stothe2/gmox-kintex-7/cryotest-kintex7.sch

## EAGLE design cryotest-kintex7.sch (2016-02-13)

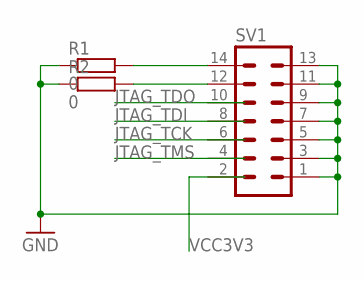
[picture p3: schematic cryotest-kintex7.sch, sheet 1]

Parts:
R1, R2: 0; R0805
SV1: MA07-2

Connections:
12_SV1: R2.2, SV1.12
14_SV1: R1.2, SV1.14
GND: R1.1, R2.1, SV1.1, SV1.3, SV1.5, SV1.7, SV1.9, SV1.11, SV1.13

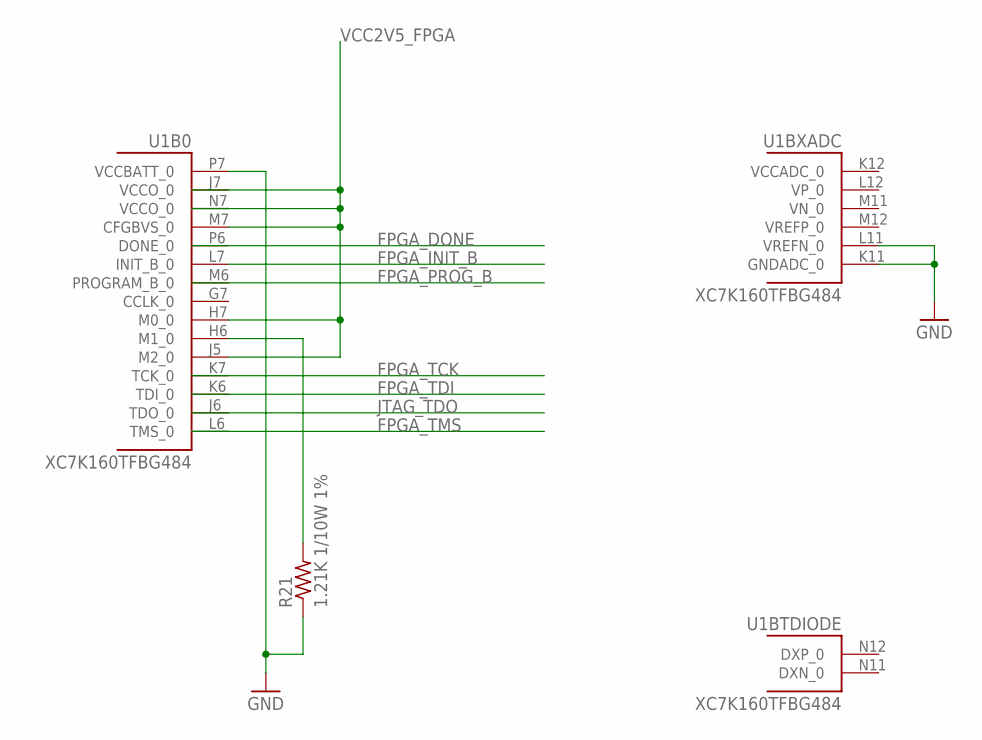
[picture p4: schematic cryotest-kintex7.sch, sheet 2]

Parts:
R21: 1.21K 1/10W 1%; R0402
U1: XC7K160TFBG484; FF484

Connections:
FPGA_INIT_B: U1.L7 (INIT_B_0)
FPGA_M1: R21.2, U1.H6 (M1_0)
GND: R21.1, U1.K11 (GNDADC_0), U1.L11 (VREFN_0), U1.P7 (VCCBATT_0)
VCC2V5_FPGA: U1.H7 (M0_0), U1.J5 (M2_0), U1.M7 (CFGBVS_0)

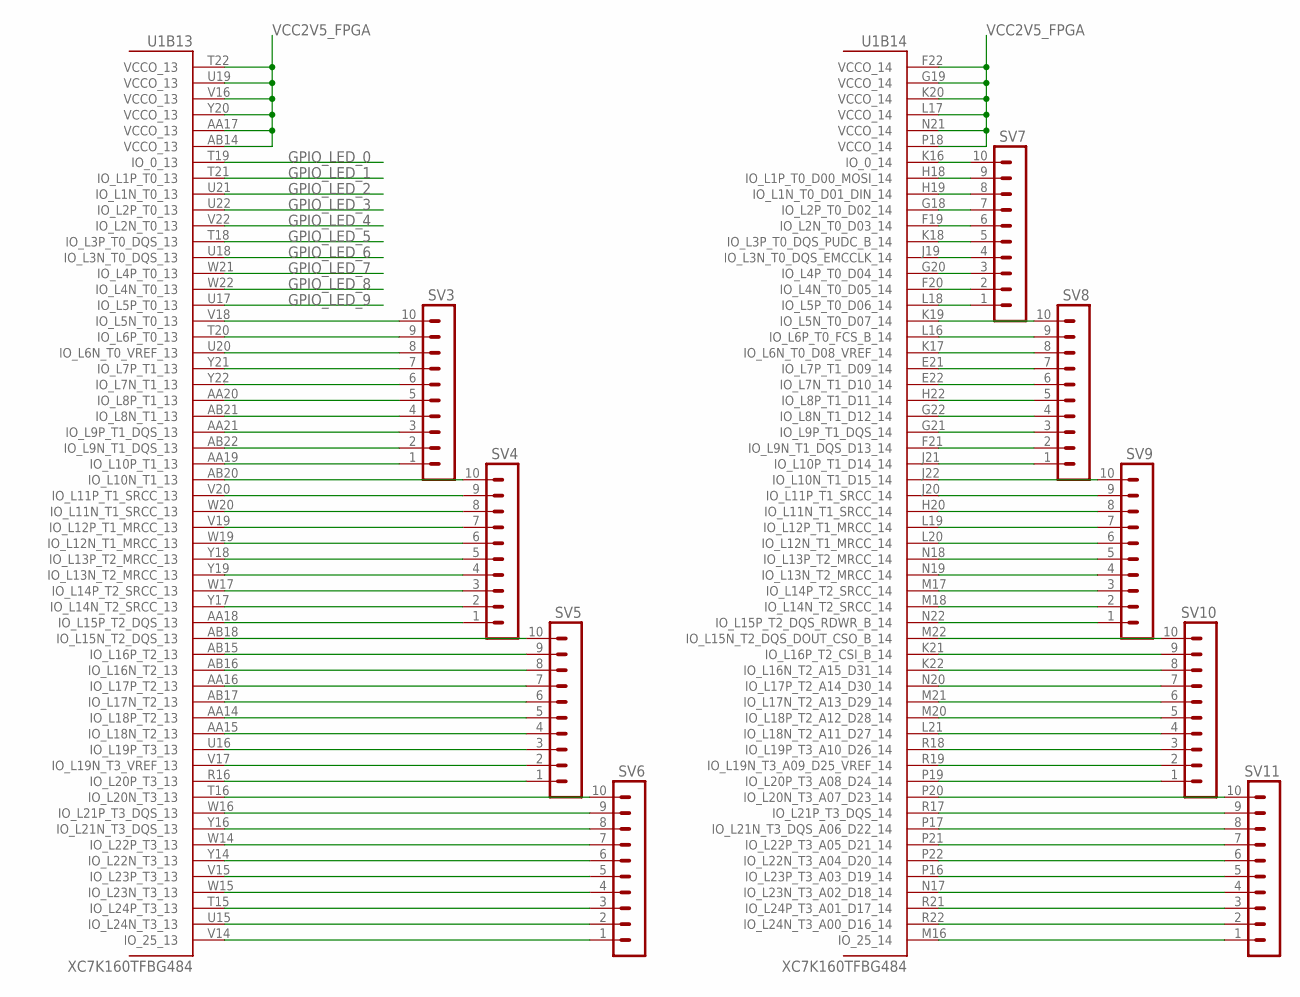
[picture p5: schematic cryotest-kintex7.sch, sheet 3]

Parts:
SV3, SV4, SV5, SV6, SV7, SV8, SV9, SV10, SV11: MA10-1
U1: XC7K160TFBG484; FF484

Connections:
GPIO_LED_0: U1.T19 (IO_0_13)
GPIO_LED_1: U1.T21 (IO_L1P_T0_13)
GPIO_LED_2: U1.U21 (IO_L1N_T0_13)
GPIO_LED_3: U1.U22 (IO_L2P_T0_13)
GPIO_LED_4: U1.V22 (IO_L2N_T0_13)
GPIO_LED_5: U1.T18 (IO_L3P_T0_DQS_13)
GPIO_LED_6: U1.U18 (IO_L3N_T0_DQS_13)
GPIO_LED_7: U1.W21 (IO_L4P_T0_13)
GPIO_LED_8: U1.W22 (IO_L4N_T0_13)
GPIO_LED_9: U1.U17 (IO_L5P_T0_13)
unnamed: SV3.10, U1.V18 (IO_L5N_T0_13)
unnamed: SV3.9, U1.T20 (IO_L6P_T0_13)
unnamed: SV3.8, U1.U20 (IO_L6N_T0_VREF_13)
unnamed: SV3.7, U1.Y21 (IO_L7P_T1_13)
unnamed: SV3.6, U1.Y22 (IO_L7N_T1_13)
unnamed: SV3.5, U1.AA20 (IO_L8P_T1_13)
unnamed: SV3.4, U1.AB21 (IO_L8N_T1_13)
unnamed: SV3.3, U1.AA21 (IO_L9P_T1_DQS_13)
unnamed: SV3.2, U1.AB22 (IO_L9N_T1_DQS_13)
unnamed: SV3.1, U1.AA19 (IO_L10P_T1_13)
unnamed: SV4.10, U1.AB20 (IO_L10N_T1_13)
unnamed: SV4.9, U1.V20 (IO_L11P_T1_SRCC_13)
unnamed: SV4.8, U1.W20 (IO_L11N_T1_SRCC_13)
unnamed: SV4.7, U1.V19 (IO_L12P_T1_MRCC_13)
unnamed: SV4.6, U1.W19 (IO_L12N_T1_MRCC_13)
unnamed: SV4.5, U1.Y18 (IO_L13P_T2_MRCC_13)
unnamed: SV4.4, U1.Y19 (IO_L13N_T2_MRCC_13)
unnamed: SV4.3, U1.W17 (IO_L14P_T2_SRCC_13)
unnamed: SV4.2, U1.Y17 (IO_L14N_T2_SRCC_13)
unnamed: SV4.1, U1.AA18 (IO_L15P_T2_DQS_13)
unnamed: SV5.10, U1.AB18 (IO_L15N_T2_DQS_13)
unnamed: SV5.9, U1.AB15 (IO_L16P_T2_13)
unnamed: SV5.8, U1.AB16 (IO_L16N_T2_13)
unnamed: SV5.7, U1.AA16 (IO_L17P_T2_13)
unnamed: SV5.6, U1.AB17 (IO_L17N_T2_13)
unnamed: SV5.5, U1.AA14 (IO_L18P_T2_13)
unnamed: SV5.4, U1.AA15 (IO_L18N_T2_13)
unnamed: SV5.3, U1.U16 (IO_L19P_T3_13)
unnamed: SV5.2, U1.V17 (IO_L19N_T3_VREF_13)
unnamed: SV5.1, U1.R16 (IO_L20P_T3_13)
unnamed: SV6.10, U1.T16 (IO_L20N_T3_13)
unnamed: SV6.9, U1.W16 (IO_L21P_T3_DQS_13)
unnamed: SV6.8, U1.Y16 (IO_L21N_T3_DQS_13)
unnamed: SV6.7, U1.W14 (IO_L22P_T3_13)
unnamed: SV6.6, U1.Y14 (IO_L22N_T3_13)
unnamed: SV6.5, U1.V15 (IO_L23P_T3_13)
unnamed: SV6.4, U1.W15 (IO_L23N_T3_13)
unnamed: SV6.3, U1.T15 (IO_L24P_T3_13)
unnamed: SV6.2, U1.U15 (IO_L24N_T3_13)
unnamed: SV6.1, U1.V14 (IO_25_13)
unnamed: SV7.10, U1.K16 (IO_0_14)
unnamed: SV7.9, U1.H18 (IO_L1P_T0_D00_MOSI_14)
unnamed: SV7.8, U1.H19 (IO_L1N_T0_D01_DIN_14)
unnamed: SV7.7, U1.G18 (IO_L2P_T0_D02_14)
unnamed: SV7.6, U1.F19 (IO_L2N_T0_D03_14)
unnamed: SV7.5, U1.K18 (IO_L3P_T0_DQS_PUDC_B_14)
unnamed: SV7.4, U1.J19 (IO_L3N_T0_DQS_EMCCLK_14)
unnamed: SV7.3, U1.G20 (IO_L4P_T0_D04_14)
unnamed: SV7.2, U1.F20 (IO_L4N_T0_D05_14)
unnamed: SV7.1, U1.L18 (IO_L5P_T0_D06_14)
unnamed: SV8.10, U1.K19 (IO_L5N_T0_D07_14)
unnamed: SV8.9, U1.L16 (IO_L6P_T0_FCS_B_14)
unnamed: SV8.8, U1.K17 (IO_L6N_T0_D08_VREF_14)
unnamed: SV8.7, U1.E21 (IO_L7P_T1_D09_14)
unnamed: SV8.6, U1.E22 (IO_L7N_T1_D10_14)
unnamed: SV8.5, U1.H22 (IO_L8P_T1_D11_14)
unnamed: SV8.4, U1.G22 (IO_L8N_T1_D12_14)
unnamed: SV8.3, U1.G21 (IO_L9P_T1_DQS_14)
unnamed: SV8.2, U1.F21 (IO_L9N_T1_DQS_D13_14)
unnamed: SV8.1, U1.J21 (IO_L10P_T1_D14_14)
unnamed: SV9.10, U1.J22 (IO_L10N_T1_D15_14)
unnamed: SV9.9, U1.J20 (IO_L11P_T1_SRCC_14)
unnamed: SV9.8, U1.H20 (IO_L11N_T1_SRCC_14)
unnamed: SV9.7, U1.L19 (IO_L12P_T1_MRCC_14)
unnamed: SV9.6, U1.L20 (IO_L12N_T1_MRCC_14)
unnamed: SV9.5, U1.N18 (IO_L13P_T2_MRCC_14)
unnamed: SV9.4, U1.N19 (IO_L13N_T2_MRCC_14)
unnamed: SV9.3, U1.M17 (IO_L14P_T2_SRCC_14)
unnamed: SV9.2, U1.M18 (IO_L14N_T2_SRCC_14)
unnamed: SV9.1, U1.N22 (IO_L15P_T2_DQS_RDWR_B_14)
unnamed: SV10.10, U1.M22 (IO_L15N_T2_DQS_DOUT_CSO_B_14)
unnamed: SV10.9, U1.K21 (IO_L16P_T2_CSI_B_14)
unnamed: SV10.8, U1.K22 (IO_L16N_T2_A15_D31_14)
unnamed: SV10.7, U1.N20 (IO_L17P_T2_A14_D30_14)
unnamed: SV10.6, U1.M21 (IO_L17N_T2_A13_D29_14)
unnamed: SV10.5, U1.M20 (IO_L18P_T2_A12_D28_14)
unnamed: SV10.4, U1.L21 (IO_L18N_T2_A11_D27_14)
unnamed: SV10.3, U1.R18 (IO_L19P_T3_A10_D26_14)
unnamed: SV10.2, U1.R19 (IO_L19N_T3_A09_D25_VREF_14)
unnamed: SV10.1, U1.P19 (IO_L20P_T3_A08_D24_14)
unnamed: SV11.10, U1.P20 (IO_L20N_T3_A07_D23_14)
unnamed: SV11.9, U1.R17 (IO_L21P_T3_DQS_14)
unnamed: SV11.8, U1.P17 (IO_L21N_T3_DQS_A06_D22_14)
unnamed: SV11.7, U1.P21 (IO_L22P_T3_A05_D21_14)
unnamed: SV11.6, U1.P22 (IO_L22N_T3_A04_D20_14)
unnamed: SV11.5, U1.P16 (IO_L23P_T3_A03_D19_14)
unnamed: SV11.4, U1.N17 (IO_L23N_T3_A02_D18_14)
unnamed: SV11.3, U1.R21 (IO_L24P_T3_A01_D17_14)
unnamed: SV11.2, U1.R22 (IO_L24N_T3_A00_D16_14)
unnamed: SV11.1, U1.M16 (IO_25_14)
VCC2V5_FPGA: U1.AA17 (VCCO_13), U1.AB14 (VCCO_13), U1.F22 (VCCO_14), U1.G19 (VCCO_14), U1.K20 (VCCO_14), U1.L17 (VCCO_14), U1.N21 (VCCO_14), U1.P18 (VCCO_14), U1.T22 (VCCO_13), U1.U19 (VCCO_13), U1.V16 (VCCO_13), U1.Y20 (VCCO_13)

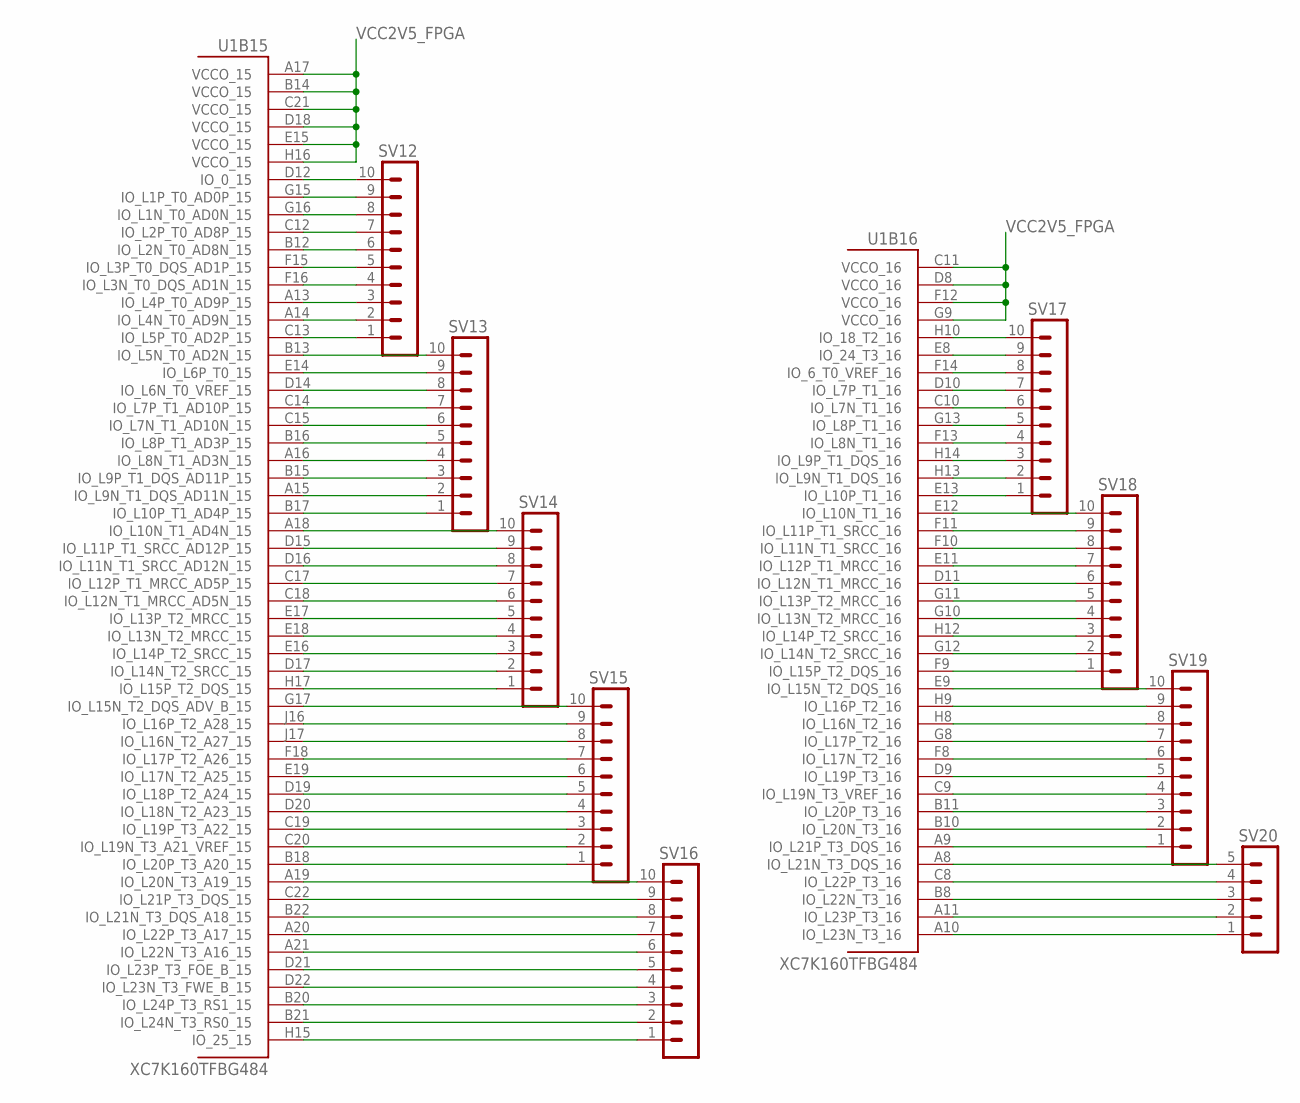
[picture p6: schematic cryotest-kintex7.sch, sheet 4]

Parts:
SV12, SV13, SV14, SV15, SV16, SV17, SV18, SV19: MA10-1
SV20: MA05-1
U1: XC7K160TFBG484; FF484

Connections:
unnamed: SV12.1, U1.C13 (IO_L5P_T0_AD2P_15)
unnamed: SV12.2, U1.A14 (IO_L4N_T0_AD9N_15)
unnamed: SV12.3, U1.A13 (IO_L4P_T0_AD9P_15)
unnamed: SV12.4, U1.F16 (IO_L3N_T0_DQS_AD1N_15)
unnamed: SV12.5, U1.F15 (IO_L3P_T0_DQS_AD1P_15)
unnamed: SV12.6, U1.B12 (IO_L2N_T0_AD8N_15)
unnamed: SV12.7, U1.C12 (IO_L2P_T0_AD8P_15)
unnamed: SV12.8, U1.G16 (IO_L1N_T0_AD0N_15)
unnamed: SV12.9, U1.G15 (IO_L1P_T0_AD0P_15)
unnamed: SV12.10, U1.D12 (IO_0_15)
unnamed: SV13.1, U1.B17 (IO_L10P_T1_AD4P_15)
unnamed: SV13.2, U1.A15 (IO_L9N_T1_DQS_AD11N_15)
unnamed: SV13.3, U1.B15 (IO_L9P_T1_DQS_AD11P_15)
unnamed: SV13.4, U1.A16 (IO_L8N_T1_AD3N_15)
unnamed: SV13.5, U1.B16 (IO_L8P_T1_AD3P_15)
unnamed: SV13.6, U1.C15 (IO_L7N_T1_AD10N_15)
unnamed: SV13.7, U1.C14 (IO_L7P_T1_AD10P_15)
unnamed: SV13.8, U1.D14 (IO_L6N_T0_VREF_15)
unnamed: SV13.9, U1.E14 (IO_L6P_T0_15)
unnamed: SV13.10, U1.B13 (IO_L5N_T0_AD2N_15)
unnamed: SV14.1, U1.H17 (IO_L15P_T2_DQS_15)
unnamed: SV14.2, U1.D17 (IO_L14N_T2_SRCC_15)
unnamed: SV14.3, U1.E16 (IO_L14P_T2_SRCC_15)
unnamed: SV14.4, U1.E18 (IO_L13N_T2_MRCC_15)
unnamed: SV14.5, U1.E17 (IO_L13P_T2_MRCC_15)
unnamed: SV14.6, U1.C18 (IO_L12N_T1_MRCC_AD5N_15)
unnamed: SV14.7, U1.C17 (IO_L12P_T1_MRCC_AD5P_15)
unnamed: SV14.8, U1.D16 (IO_L11N_T1_SRCC_AD12N_15)
unnamed: SV14.9, U1.D15 (IO_L11P_T1_SRCC_AD12P_15)
unnamed: SV14.10, U1.A18 (IO_L10N_T1_AD4N_15)
unnamed: SV15.1, U1.B18 (IO_L20P_T3_A20_15)
unnamed: SV15.2, U1.C20 (IO_L19N_T3_A21_VREF_15)
unnamed: SV15.3, U1.C19 (IO_L19P_T3_A22_15)
unnamed: SV15.4, U1.D20 (IO_L18N_T2_A23_15)
unnamed: SV15.5, U1.D19 (IO_L18P_T2_A24_15)
unnamed: SV15.6, U1.E19 (IO_L17N_T2_A25_15)
unnamed: SV15.7, U1.F18 (IO_L17P_T2_A26_15)
unnamed: SV15.8, U1.J17 (IO_L16N_T2_A27_15)
unnamed: SV15.9, U1.J16 (IO_L16P_T2_A28_15)
unnamed: SV15.10, U1.G17 (IO_L15N_T2_DQS_ADV_B_15)
unnamed: SV16.1, U1.H15 (IO_25_15)
unnamed: SV16.2, U1.B21 (IO_L24N_T3_RS0_15)
unnamed: SV16.3, U1.B20 (IO_L24P_T3_RS1_15)
unnamed: SV16.4, U1.D22 (IO_L23N_T3_FWE_B_15)
unnamed: SV16.5, U1.D21 (IO_L23P_T3_FOE_B_15)
unnamed: SV16.6, U1.A21 (IO_L22N_T3_A16_15)
unnamed: SV16.7, U1.A20 (IO_L22P_T3_A17_15)
unnamed: SV16.8, U1.B22 (IO_L21N_T3_DQS_A18_15)
unnamed: SV16.9, U1.C22 (IO_L21P_T3_DQS_15)
unnamed: SV16.10, U1.A19 (IO_L20N_T3_A19_15)
unnamed: SV17.1, U1.E13 (IO_L10P_T1_16)
unnamed: SV17.2, U1.H13 (IO_L9N_T1_DQS_16)
unnamed: SV17.3, U1.H14 (IO_L9P_T1_DQS_16)
unnamed: SV17.4, U1.F13 (IO_L8N_T1_16)
unnamed: SV17.5, U1.G13 (IO_L8P_T1_16)
unnamed: SV17.6, U1.C10 (IO_L7N_T1_16)
unnamed: SV17.7, U1.D10 (IO_L7P_T1_16)
unnamed: SV17.8, U1.F14 (IO_6_T0_VREF_16)
unnamed: SV17.9, U1.E8 (IO_24_T3_16)
unnamed: SV17.10, U1.H10 (IO_18_T2_16)
unnamed: SV18.1, U1.F9 (IO_L15P_T2_DQS_16)
unnamed: SV18.2, U1.G12 (IO_L14N_T2_SRCC_16)
unnamed: SV18.3, U1.H12 (IO_L14P_T2_SRCC_16)
unnamed: SV18.4, U1.G10 (IO_L13N_T2_MRCC_16)
unnamed: SV18.5, U1.G11 (IO_L13P_T2_MRCC_16)
unnamed: SV18.6, U1.D11 (IO_L12N_T1_MRCC_16)
unnamed: SV18.7, U1.E11 (IO_L12P_T1_MRCC_16)
unnamed: SV18.8, U1.F10 (IO_L11N_T1_SRCC_16)
unnamed: SV18.9, U1.F11 (IO_L11P_T1_SRCC_16)
unnamed: SV18.10, U1.E12 (IO_L10N_T1_16)
unnamed: SV19.1, U1.A9 (IO_L21P_T3_DQS_16)
unnamed: SV19.2, U1.B10 (IO_L20N_T3_16)
unnamed: SV19.3, U1.B11 (IO_L20P_T3_16)
unnamed: SV19.4, U1.C9 (IO_L19N_T3_VREF_16)
unnamed: SV19.5, U1.D9 (IO_L19P_T3_16)
unnamed: SV19.6, U1.F8 (IO_L17N_T2_16)
unnamed: SV19.7, U1.G8 (IO_L17P_T2_16)
unnamed: SV19.8, U1.H8 (IO_L16N_T2_16)
unnamed: SV19.9, U1.H9 (IO_L16P_T2_16)
unnamed: SV19.10, U1.E9 (IO_L15N_T2_DQS_16)
unnamed: SV20.1, U1.A10 (IO_L23N_T3_16)
unnamed: SV20.2, U1.A11 (IO_L23P_T3_16)
unnamed: SV20.3, U1.B8 (IO_L22N_T3_16)
unnamed: SV20.4, U1.C8 (IO_L22P_T3_16)
unnamed: SV20.5, U1.A8 (IO_L21N_T3_DQS_16)
VCC2V5_FPGA: U1.A17 (VCCO_15), U1.B14 (VCCO_15), U1.C11 (VCCO_16), U1.C21 (VCCO_15), U1.D8 (VCCO_16), U1.D18 (VCCO_15), U1.E15 (VCCO_15), U1.F12 (VCCO_16), U1.G9 (VCCO_16), U1.H16 (VCCO_15)

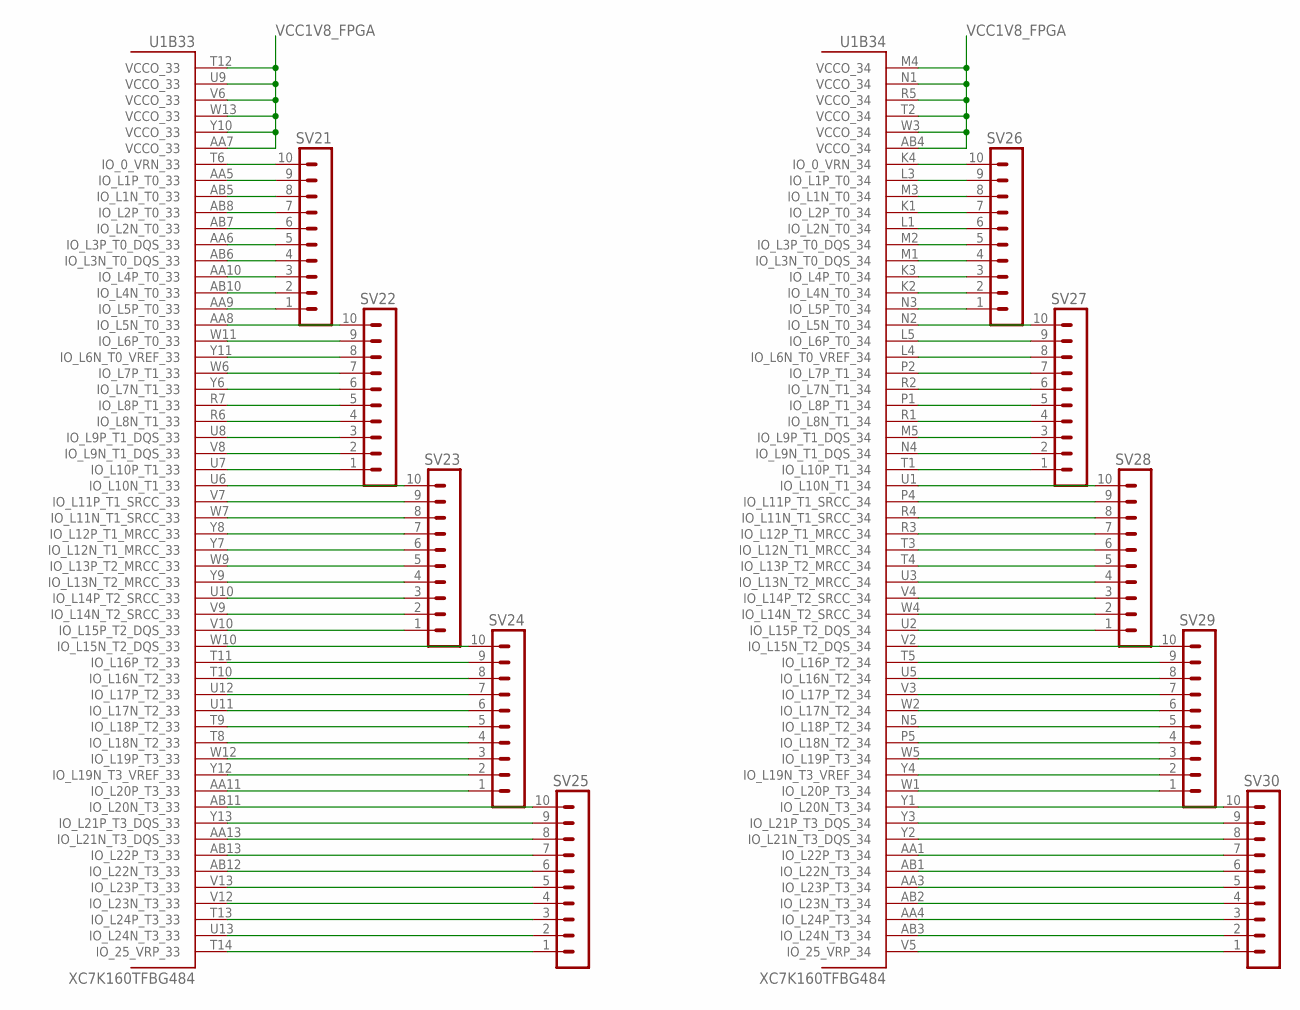
[picture p7: schematic cryotest-kintex7.sch, sheet 5]

Parts:
SV21, SV22, SV23, SV24, SV25, SV26, SV27, SV28, SV29, SV30: MA10-1
U1: XC7K160TFBG484; FF484

Connections:
unnamed: SV21.1, U1.AA9 (IO_L5P_T0_33)
unnamed: SV21.2, U1.AB10 (IO_L4N_T0_33)
unnamed: SV21.3, U1.AA10 (IO_L4P_T0_33)
unnamed: SV21.4, U1.AB6 (IO_L3N_T0_DQS_33)
unnamed: SV21.5, U1.AA6 (IO_L3P_T0_DQS_33)
unnamed: SV21.6, U1.AB7 (IO_L2N_T0_33)
unnamed: SV21.7, U1.AB8 (IO_L2P_T0_33)
unnamed: SV21.8, U1.AB5 (IO_L1N_T0_33)
unnamed: SV21.9, U1.AA5 (IO_L1P_T0_33)
unnamed: SV21.10, U1.T6 (IO_0_VRN_33)
unnamed: SV22.1, U1.U7 (IO_L10P_T1_33)
unnamed: SV22.2, U1.V8 (IO_L9N_T1_DQS_33)
unnamed: SV22.3, U1.U8 (IO_L9P_T1_DQS_33)
unnamed: SV22.4, U1.R6 (IO_L8N_T1_33)
unnamed: SV22.5, U1.R7 (IO_L8P_T1_33)
unnamed: SV22.6, U1.Y6 (IO_L7N_T1_33)
unnamed: SV22.7, U1.W6 (IO_L7P_T1_33)
unnamed: SV22.8, U1.Y11 (IO_L6N_T0_VREF_33)
unnamed: SV22.9, U1.W11 (IO_L6P_T0_33)
unnamed: SV22.10, U1.AA8 (IO_L5N_T0_33)
unnamed: SV23.1, U1.V10 (IO_L15P_T2_DQS_33)
unnamed: SV23.2, U1.V9 (IO_L14N_T2_SRCC_33)
unnamed: SV23.3, U1.U10 (IO_L14P_T2_SRCC_33)
unnamed: SV23.4, U1.Y9 (IO_L13N_T2_MRCC_33)
unnamed: SV23.5, U1.W9 (IO_L13P_T2_MRCC_33)
unnamed: SV23.6, U1.Y7 (IO_L12N_T1_MRCC_33)
unnamed: SV23.7, U1.Y8 (IO_L12P_T1_MRCC_33)
unnamed: SV23.8, U1.W7 (IO_L11N_T1_SRCC_33)
unnamed: SV23.9, U1.V7 (IO_L11P_T1_SRCC_33)
unnamed: SV23.10, U1.U6 (IO_L10N_T1_33)
unnamed: SV24.1, U1.AA11 (IO_L20P_T3_33)
unnamed: SV24.2, U1.Y12 (IO_L19N_T3_VREF_33)
unnamed: SV24.3, U1.W12 (IO_L19P_T3_33)
unnamed: SV24.4, U1.T8 (IO_L18N_T2_33)
unnamed: SV24.5, U1.T9 (IO_L18P_T2_33)
unnamed: SV24.6, U1.U11 (IO_L17N_T2_33)
unnamed: SV24.7, U1.U12 (IO_L17P_T2_33)
unnamed: SV24.8, U1.T10 (IO_L16N_T2_33)
unnamed: SV24.9, U1.T11 (IO_L16P_T2_33)
unnamed: SV24.10, U1.W10 (IO_L15N_T2_DQS_33)
unnamed: SV25.1, U1.T14 (IO_25_VRP_33)
unnamed: SV25.2, U1.U13 (IO_L24N_T3_33)
unnamed: SV25.3, U1.T13 (IO_L24P_T3_33)
unnamed: SV25.4, U1.V12 (IO_L23N_T3_33)
unnamed: SV25.5, U1.V13 (IO_L23P_T3_33)
unnamed: SV25.6, U1.AB12 (IO_L22N_T3_33)
unnamed: SV25.7, U1.AB13 (IO_L22P_T3_33)
unnamed: SV25.8, U1.AA13 (IO_L21N_T3_DQS_33)
unnamed: SV25.9, U1.Y13 (IO_L21P_T3_DQS_33)
unnamed: SV25.10, U1.AB11 (IO_L20N_T3_33)
unnamed: SV26.1, U1.N3 (IO_L5P_T0_34)
unnamed: SV26.2, U1.K2 (IO_L4N_T0_34)
unnamed: SV26.3, U1.K3 (IO_L4P_T0_34)
unnamed: SV26.4, U1.M1 (IO_L3N_T0_DQS_34)
unnamed: SV26.5, U1.M2 (IO_L3P_T0_DQS_34)
unnamed: SV26.6, U1.L1 (IO_L2N_T0_34)
unnamed: SV26.7, U1.K1 (IO_L2P_T0_34)
unnamed: SV26.8, U1.M3 (IO_L1N_T0_34)
unnamed: SV26.9, U1.L3 (IO_L1P_T0_34)
unnamed: SV26.10, U1.K4 (IO_0_VRN_34)
unnamed: SV27.1, U1.T1 (IO_L10P_T1_34)
unnamed: SV27.2, U1.N4 (IO_L9N_T1_DQS_34)
unnamed: SV27.3, U1.M5 (IO_L9P_T1_DQS_34)
unnamed: SV27.4, U1.R1 (IO_L8N_T1_34)
unnamed: SV27.5, U1.P1 (IO_L8P_T1_34)
unnamed: SV27.6, U1.R2 (IO_L7N_T1_34)
unnamed: SV27.7, U1.P2 (IO_L7P_T1_34)
unnamed: SV27.8, U1.L4 (IO_L6N_T0_VREF_34)
unnamed: SV27.9, U1.L5 (IO_L6P_T0_34)
unnamed: SV27.10, U1.N2 (IO_L5N_T0_34)
unnamed: SV28.1, U1.U2 (IO_L15P_T2_DQS_34)
unnamed: SV28.2, U1.W4 (IO_L14N_T2_SRCC_34)
unnamed: SV28.3, U1.V4 (IO_L14P_T2_SRCC_34)
unnamed: SV28.4, U1.U3 (IO_L13N_T2_MRCC_34)
unnamed: SV28.5, U1.T4 (IO_L13P_T2_MRCC_34)
unnamed: SV28.6, U1.T3 (IO_L12N_T1_MRCC_34)
unnamed: SV28.7, U1.R3 (IO_L12P_T1_MRCC_34)
unnamed: SV28.8, U1.R4 (IO_L11N_T1_SRCC_34)
unnamed: SV28.9, U1.P4 (IO_L11P_T1_SRCC_34)
unnamed: SV28.10, U1.U1 (IO_L10N_T1_34)
unnamed: SV29.1, U1.W1 (IO_L20P_T3_34)
unnamed: SV29.2, U1.Y4 (IO_L19N_T3_VREF_34)
unnamed: SV29.3, U1.W5 (IO_L19P_T3_34)
unnamed: SV29.4, U1.P5 (IO_L18N_T2_34)
unnamed: SV29.5, U1.N5 (IO_L18P_T2_34)
unnamed: SV29.6, U1.W2 (IO_L17N_T2_34)
unnamed: SV29.7, U1.V3 (IO_L17P_T2_34)
unnamed: SV29.8, U1.U5 (IO_L16N_T2_34)
unnamed: SV29.9, U1.T5 (IO_L16P_T2_34)
unnamed: SV29.10, U1.V2 (IO_L15N_T2_DQS_34)
unnamed: SV30.1, U1.V5 (IO_25_VRP_34)
unnamed: SV30.2, U1.AB3 (IO_L24N_T3_34)
unnamed: SV30.3, U1.AA4 (IO_L24P_T3_34)
unnamed: SV30.4, U1.AB2 (IO_L23N_T3_34)
unnamed: SV30.5, U1.AA3 (IO_L23P_T3_34)
unnamed: SV30.6, U1.AB1 (IO_L22N_T3_34)
unnamed: SV30.7, U1.AA1 (IO_L22P_T3_34)
unnamed: SV30.8, U1.Y2 (IO_L21N_T3_DQS_34)
unnamed: SV30.9, U1.Y3 (IO_L21P_T3_DQS_34)
unnamed: SV30.10, U1.Y1 (IO_L20N_T3_34)
VCC1V8_FPGA: U1.AA7 (VCCO_33), U1.AB4 (VCCO_34), U1.M4 (VCCO_34), U1.N1 (VCCO_34), U1.R5 (VCCO_34), U1.T2 (VCCO_34), U1.T12 (VCCO_33), U1.U9 (VCCO_33), U1.V6 (VCCO_33), U1.W3 (VCCO_34), U1.W13 (VCCO_33), U1.Y10 (VCCO_33)

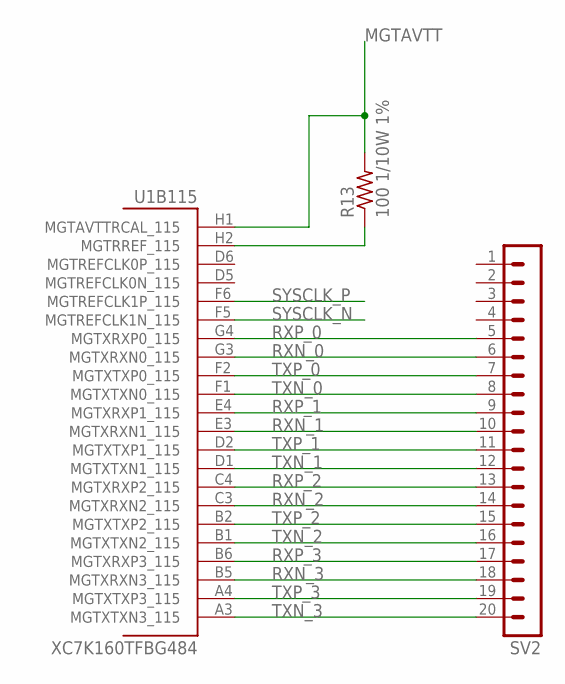
[picture p8: schematic cryotest-kintex7.sch, sheet 6]

Parts:
R13: 100 1/10W 1%; R0402
SV2: MA20-1
U1: XC7K160TFBG484; FF484

Connections:
H2: R13.1, U1.H2 (MGTRREF_115)
MGTAVTT: R13.2, U1.H1 (MGTAVTTRCAL_115)
RXN_0: SV2.6, U1.G3 (MGTXRXN0_115)
RXN_1: SV2.10, U1.E3 (MGTXRXN1_115)
RXN_2: SV2.14, U1.C3 (MGTXRXN2_115)
RXN_3: SV2.18, U1.B5 (MGTXRXN3_115)
RXP_0: SV2.5, U1.G4 (MGTXRXP0_115)
RXP_1: SV2.9, U1.E4 (MGTXRXP1_115)
RXP_2: SV2.13, U1.C4 (MGTXRXP2_115)
RXP_3: SV2.17, U1.B6 (MGTXRXP3_115)
SYSCLK_N: U1.F5 (MGTREFCLK1N_115)
SYSCLK_P: U1.F6 (MGTREFCLK1P_115)
TXN_0: SV2.8, U1.F1 (MGTXTXN0_115)
TXN_1: SV2.12, U1.D1 (MGTXTXN1_115)
TXN_2: SV2.16, U1.B1 (MGTXTXN2_115)
TXN_3: SV2.20, U1.A3 (MGTXTXN3_115)
TXP_0: SV2.7, U1.F2 (MGTXTXP0_115)
TXP_1: SV2.11, U1.D2 (MGTXTXP1_115)
TXP_2: SV2.15, U1.B2 (MGTXTXP2_115)
TXP_3: SV2.19, U1.A4 (MGTXTXP3_115)

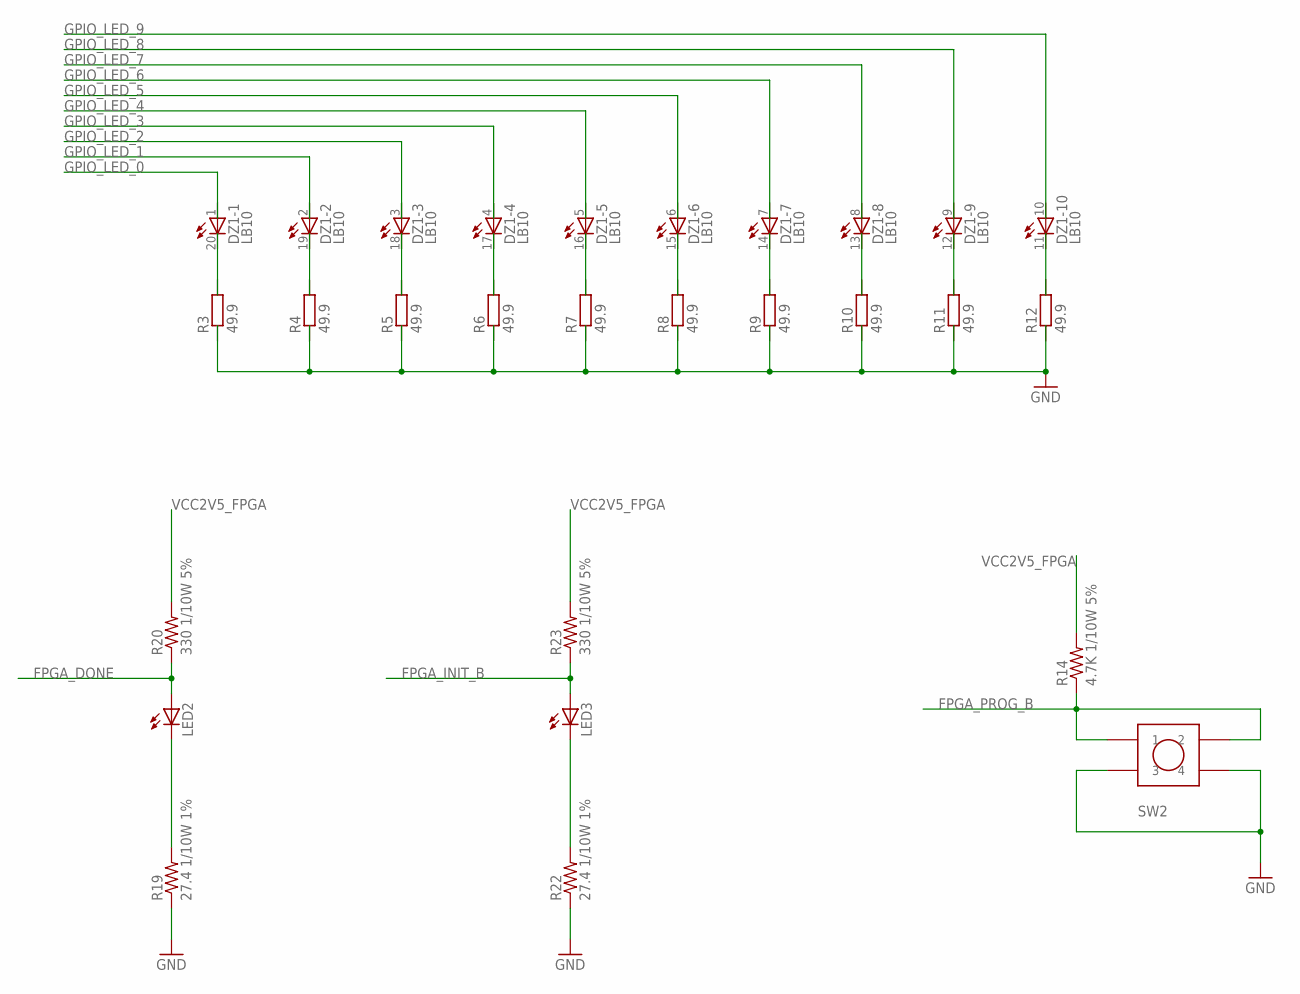
[picture p9: schematic cryotest-kintex7.sch, sheet 7]

Parts:
DZ1: LB10
LED2, LED3: LEDSML0603; SML0603
R3, R4, R5, R6, R7, R8, R9, R10, R11, R12: 49.9; R0603
R14: 4.7K 1/10W 5%; R0402
R19, R22: 27.4 1/10W 1%; R0402
R20, R23: 330 1/10W 5%; R0603
SW2: TL3301EF100QG"; GULL-WING

Connections:
FPGA_DONE: LED2.A, R20.1
FPGA_INIT_B: LED3.A, R23.1
FPGA_PROG_B: R14.1, SW2.P$1 (1), SW2.P$2 (2)
GND: R19.1, R22.1, SW2.P$3 (3), SW2.P$4 (4)
unnamed: LED2.C, R19.2
unnamed: LED3.C, R22.2
VCC2V5_FPGA: R14.2, R20.2, R23.2

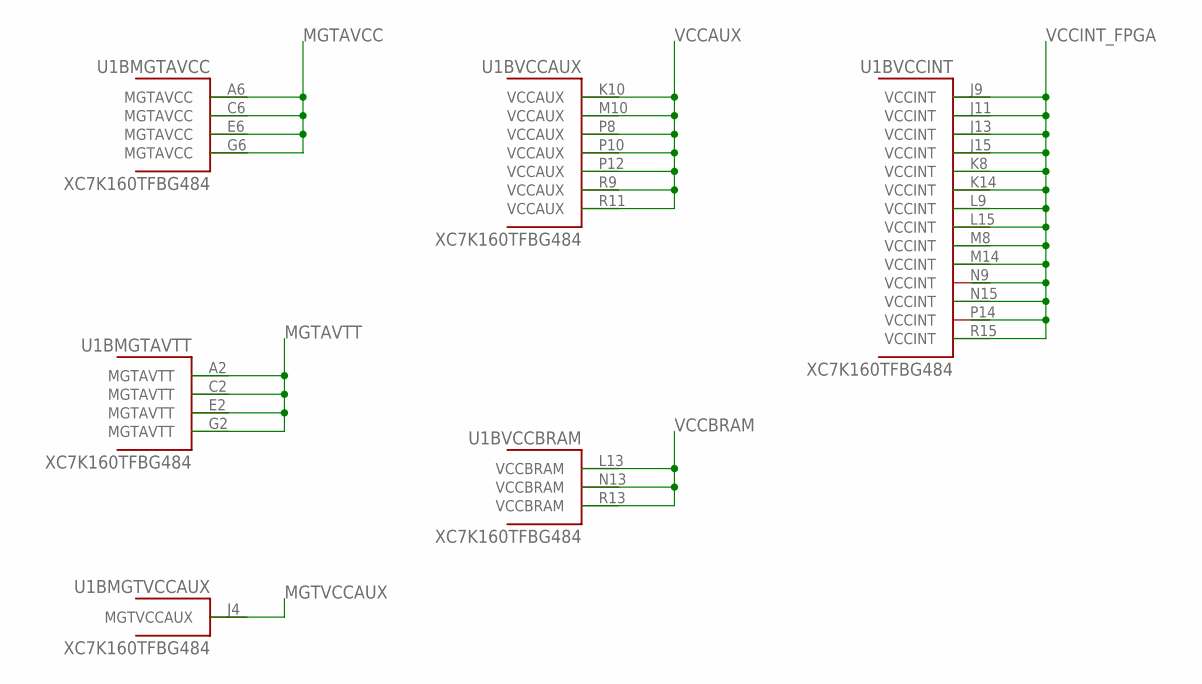
[picture p10: schematic cryotest-kintex7.sch, sheet 8]

Parts:
U1: XC7K160TFBG484; FF484

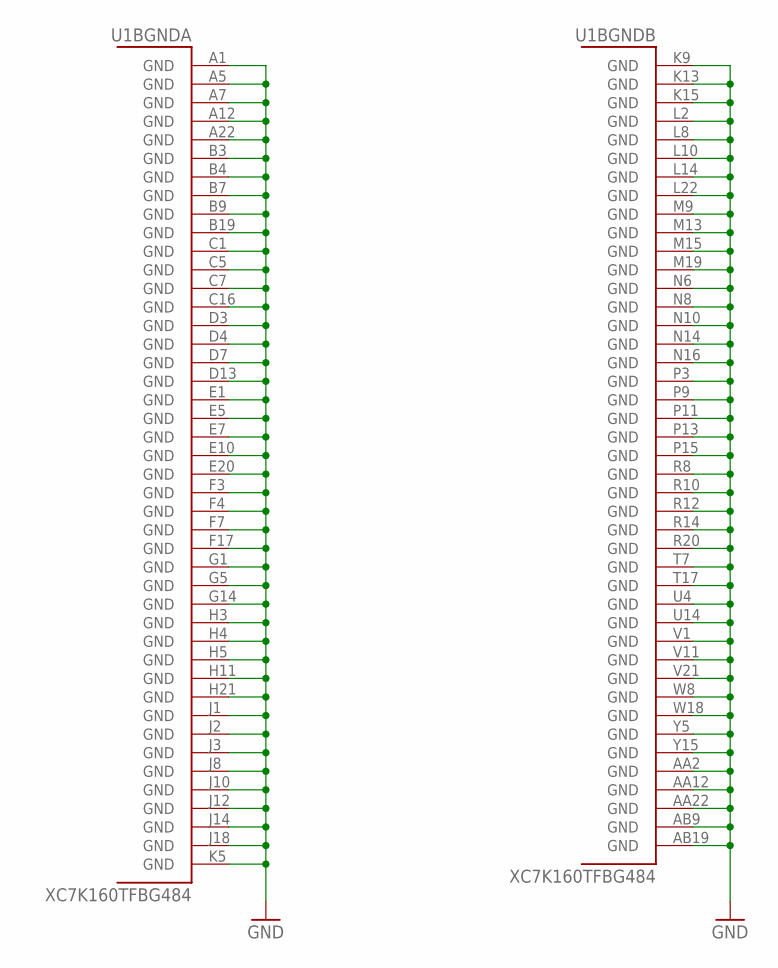
[picture p11: schematic cryotest-kintex7.sch, sheet 9]

Parts:
U1: XC7K160TFBG484; FF484

Connections:
GND: U1.A1 (GND), U1.A5 (GND), U1.A7 (GND), U1.A12 (GND), U1.A22 (GND), U1.AA2 (GND), U1.AA12 (GND), U1.AA22 (GND), U1.AB9 (GND), U1.AB19 (GND), U1.B3 (GND), U1.B4 (GND), U1.B7 (GND), U1.B9 (GND), U1.B19 (GND), U1.C1 (GND), U1.C5 (GND), U1.C7 (GND), U1.C16 (GND), U1.D3 (GND), U1.D4 (GND), U1.D7 (GND), U1.D13 (GND), U1.E1 (GND), U1.E5 (GND), U1.E7 (GND), U1.E10 (GND), U1.E20 (GND), U1.F3 (GND), U1.F4 (GND), U1.F7 (GND), U1.F17 (GND), U1.G1 (GND), U1.G5 (GND), U1.G14 (GND), U1.H3 (GND), U1.H4 (GND), U1.H5 (GND), U1.H11 (GND), U1.H21 (GND), U1.J1 (GND), U1.J2 (GND), U1.J3 (GND), U1.J8 (GND), U1.J10 (GND), U1.J12 (GND), U1.J14 (GND), U1.J18 (GND), U1.K5 (GND), U1.K9 (GND), U1.K13 (GND), U1.K15 (GND), U1.L2 (GND), U1.L8 (GND), U1.L10 (GND), U1.L14 (GND), U1.L22 (GND), U1.M9 (GND), U1.M13 (GND), U1.M15 (GND), U1.M19 (GND), U1.N6 (GND), U1.N8 (GND), U1.N10 (GND), U1.N14 (GND), U1.N16 (GND), U1.P3 (GND), U1.P9 (GND), U1.P11 (GND), U1.P13 (GND), U1.P15 (GND), U1.R8 (GND), U1.R10 (GND), U1.R12 (GND), U1.R14 (GND), U1.R20 (GND), U1.T7 (GND), U1.T17 (GND), U1.U4 (GND), U1.U14 (GND), U1.V1 (GND), U1.V11 (GND), U1.V21 (GND), U1.W8 (GND), U1.W18 (GND), U1.Y5 (GND), U1.Y15 (GND)

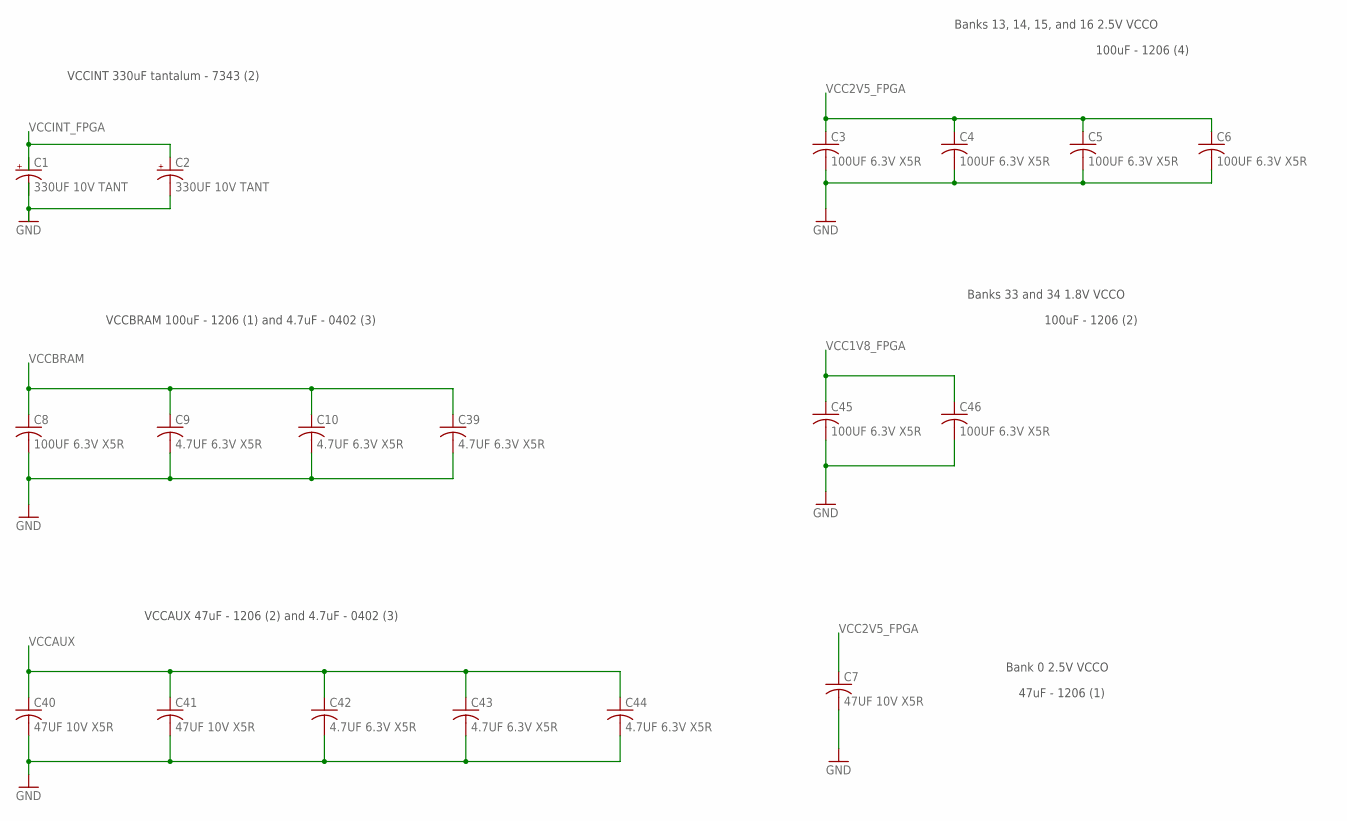
[picture p12: schematic cryotest-kintex7.sch, sheet 10]

Parts:
C1, C2: 330UF 10V TANT; CT7343
C3, C4, C5, C6, C8, C45, C46: 100UF 6.3V X5R; C1206
C7, C40, C41: 47UF 10V X5R; C1206
C9, C10, C39: 4.7UF 6.3V X5R; C0402
C42, C43, C44: 4.7UF 6.3V X5R; C1206

Connections:
GND: C2.-, C3.2, C4.2, C5.2, C6.2, C7.2, C8.2, C9.2, C10.2, C39.2, C40.2, C41.2, C42.2, C43.2, C44.2, C45.2, C46.2
VCC1V8_FPGA: C45.1, C46.1
VCC2V5_FPGA: C3.1, C4.1, C5.1, C6.1, C7.1
VCCAUX: C40.1, C41.1, C42.1, C43.1, C44.1
VCCBRAM: C8.1, C9.1, C10.1, C39.1
VCCINT_FPGA: C2.+

Notes on the sheet:
100uF - 1206 (4)
Banks 13, 14, 15, and 16 2.5V VCCO
VCCINT 330uF tantalum - 7343 (2)
Bank 0 2.5V VCCO
47uF - 1206 (1)
VCCBRAM 100uF - 1206 (1) and 4.7uF - 0402 (3)
VCCAUX 47uF - 1206 (2) and 4.7uF - 0402 (3)
Banks 33 and 34 1.8V VCCO
100uF - 1206 (2)

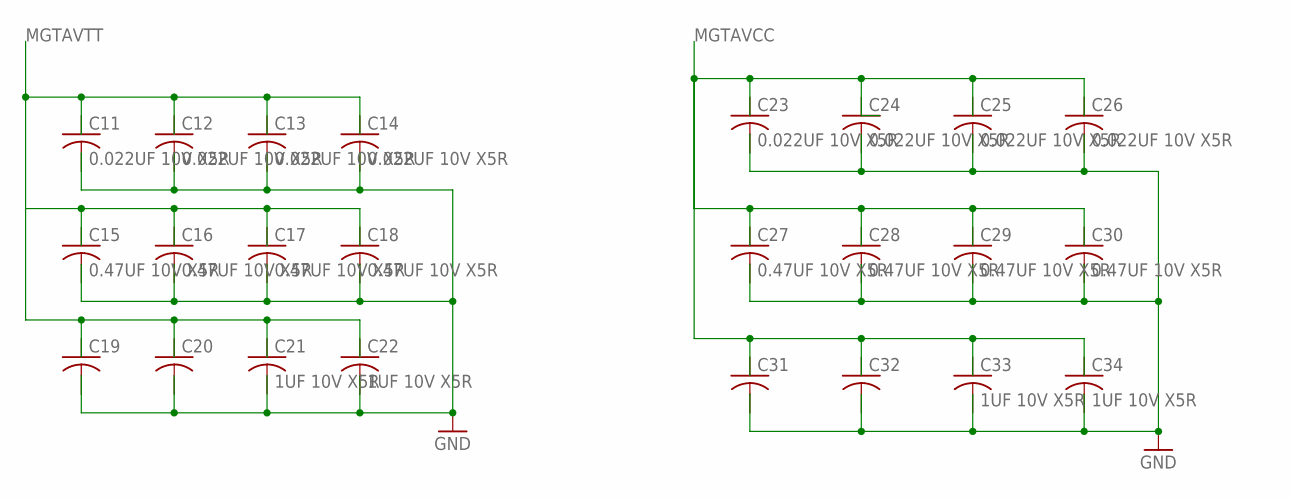
[picture p13: schematic cryotest-kintex7.sch, sheet 11]

Parts:
C11, C12, C13, C14, C23, C24, C25, C26: 0.022UF 10V X5R; C0603
C15, C16, C17, C18, C27, C28, C29, C30: 0.47UF 10V X5R; C0603
C19, C20, C31, C32: C-US01005; C01005
C21, C22, C33, C34: 1UF 10V X5R; C0603

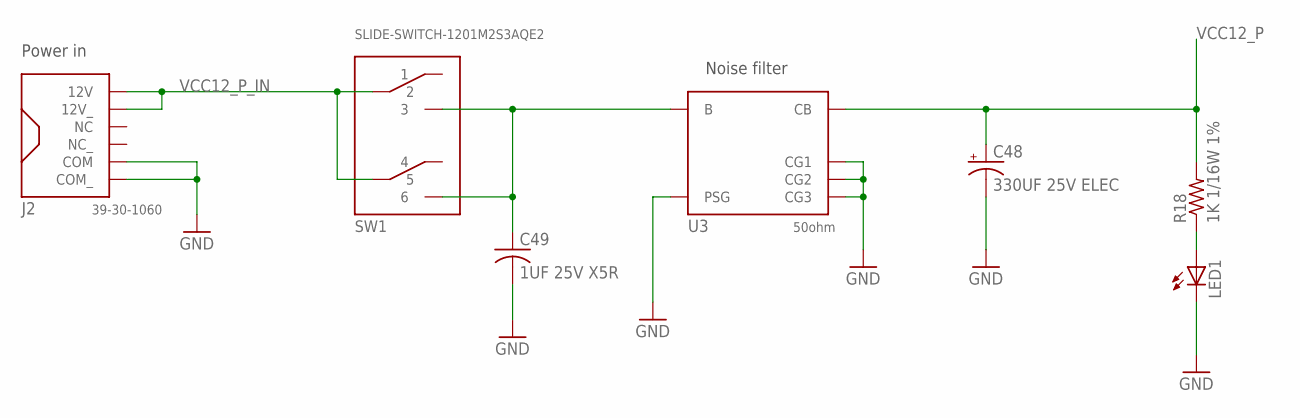
[picture p14: schematic cryotest-kintex7.sch, sheet 12]

Parts:
C48: 330UF 25V ELEC; PANASONIC_F
C49: 1UF 25V X5R; C0603
J2: 39-30-1060; 5569_6P
LED1: LEDSML0603; SML0603
R18: 1K 1/16W 1%; R0402
SW1: SLIDE-SWITCH-1201M2S3AQE2; HORIZONTAL-DPDT
U3: 50ohm; BNX016-01

Connections:
GND: C48.-, C49.2, J2.P$3 (COM), J2.P$6 (COM_), LED1.C, U3.CG$1 (CG3), U3.CG$2 (CG2), U3.P$3 (PSG), U3.P$4 (CG1)
unnamed: LED1.A, R18.1
VCC12_P: C48.+, R18.2, U3.P$2 (CB)
VCC12_P_FILTER_IN: C49.1, SW1.3, SW1.6, U3.P$1 (B)
VCC12_P_IN: J2.P$1 (12V), J2.P$4 (12V_), SW1.2, SW1.5

Notes on the sheet:
Noise filter
Power in

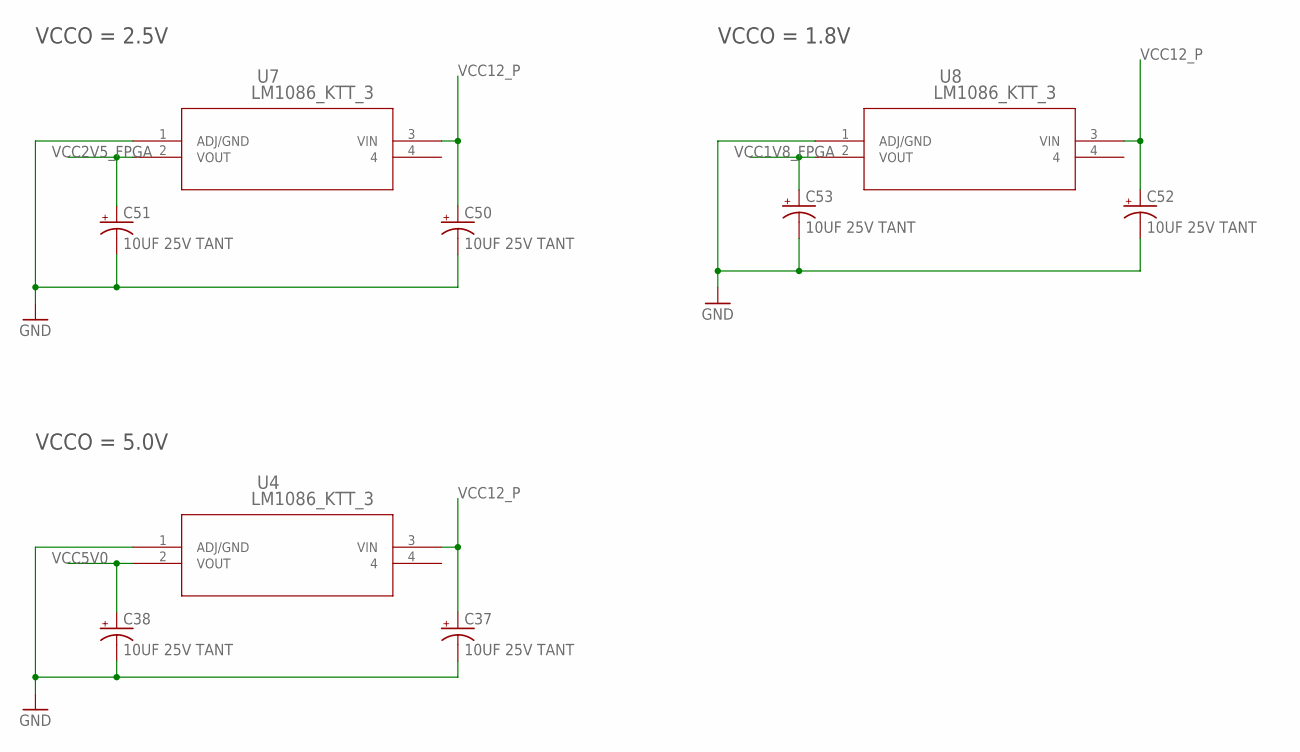
[picture p15: schematic cryotest-kintex7.sch, sheet 13]

Parts:
C37, C38, C50, C51, C52, C53: 10UF 25V TANT; CT7343
U4, U7, U8: LM1086_KTT_3; TS3B

Connections:
GND: C37.-, C38.-, C50.-, C51.-, C52.-, C53.-, U4.1 (ADJ/GND), U7.1 (ADJ/GND), U8.1 (ADJ/GND)
VCC1V8_FPGA: C53.+, U8.2 (VOUT)
VCC2V5_FPGA: C51.+, U7.2 (VOUT)
VCC5V0: C38.+, U4.2 (VOUT)
VCC12_P: C37.+, C50.+, C52.+, U4.3 (VIN), U7.3 (VIN), U8.3 (VIN)

Notes on the sheet:
VCCO = 2.5V
VCCO = 1.8V
VCCO = 5.0V

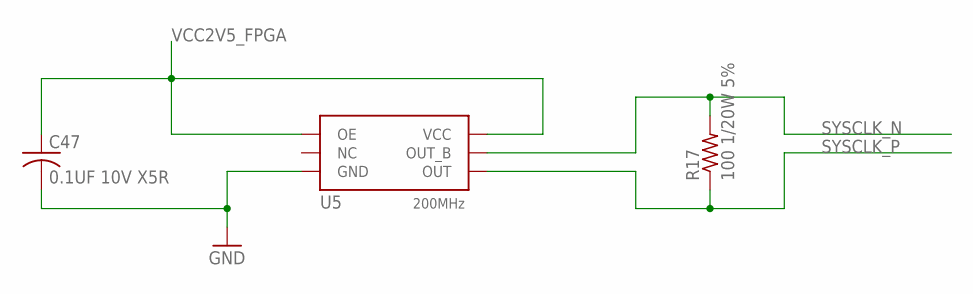
[picture p16: schematic cryotest-kintex7.sch, sheet 14]

Parts:
C47: 0.1UF 10V X5R; C0402
R17: 100 1/20W 5%; R0201
U5: 200MHz; 7X5

Connections:
GND: C47.2, U5.P$3 (GND)
SYSCLK_N: R17.2, U5.P$5 (OUT_B)
SYSCLK_P: R17.1, U5.P$4 (OUT)
VCC2V5_FPGA: C47.1, U5.P$1 (OE), U5.P$6 (VCC)
