stothe2/gmox-kintex-7/cryotest-kintex7.sch

## EAGLE design cryotest-kintex7.sch (continued)

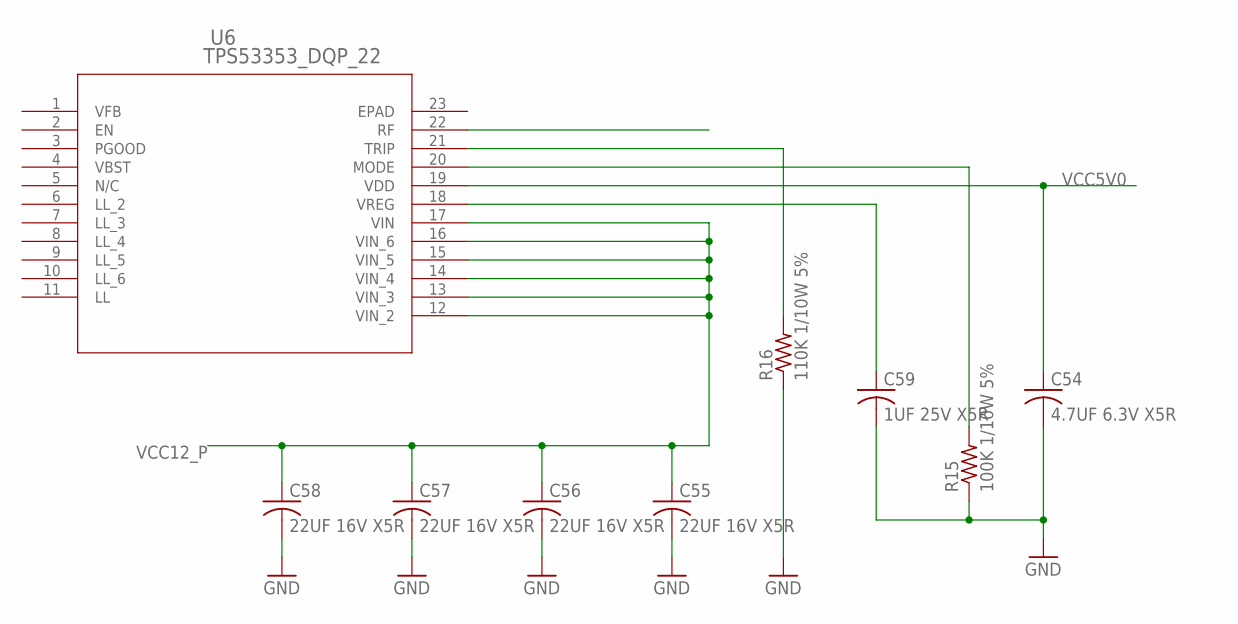
[picture p17: schematic cryotest-kintex7.sch, sheet 15]

Parts:
C54: 4.7UF 6.3V X5R; C0402
C55, C56, C57, C58: 22UF 16V X5R; C1206
C59: 1UF 25V X5R; C0603
R15: 100K 1/10W 5%; R0402
R16: 110K 1/10W 5%; R0402
U6: TPS53353_DQP_22; DQP22_5P479X3P24

Connections:
GND: C54.2, C55.2, C56.2, C57.2, C58.2, C59.2, R15.1, R16.1
unnamed: R15.2, U6.20 (MODE)
RF: U6.22 (RF)
TRIP: R16.2, U6.21 (TRIP)
VCC5V0: C54.1, U6.19 (VDD)
VCC12_P: C55.1, C56.1, C57.1, C58.1, U6.12 (VIN_2), U6.13 (VIN_3), U6.14 (VIN_4), U6.15 (VIN_5), U6.16 (VIN_6), U6.17 (VIN)
VREG: C59.1, U6.18 (VREG)
