stothe2/gmox-kintex-7/(commit log)

2015-12-12 Create filter library
2015-12-12 Create switch library
2015-12-12 Create LC filter library
2015-12-13 Update BOM
    [GMOX-BOM-Kintex-XC7K160TFBG484 - Sheet1.tsv]
2015-12-23 Create power connector library
2015-12-23 Update power connector library
2016-01-19 Update regulator libraries
2016-02-13 Add push-button library
2016-02-13 Add schematic
    Switching regulators and ADC interface yet to be added.
    [cryotest-kintex7.sch]
